cartheur/M68000-I-SBC/fabrication/production-draft/drill-report.txt

Drill report for 68000sbc.kicad_pcb
Created on 2026-10-28T14:22:47

Copper Layer Stackup:
    =============================================================
    L1 :  F.Cu                      front
    L2 :  B.Cu                      back

Drill file '68000sbc-PTH.drl' contains
    plated through holes:
    =============================================================
    T1  0.330mm  0.0130"  (269 holes))
    T2  0.700mm  0.0276"  (14 holes))
    T3  0.800mm  0.0315"  (341 holes))
    T4  0.900mm  0.0354"  (8 holes))
    T5  0.920mm  0.0362"  (4 holes))
    T6  1.000mm  0.0394"  (16 holes))
    T7  1.100mm  0.0433"  (8 holes))
    T8  2.330mm  0.0917"  (2 holes))
    T9  2.700mm  0.1063"  (4 holes))

    Total plated holes count 666

Drill file '68000sbc-NPTH.drl' contains
    unplated through holes:
    =============================================================

    Total unplated holes count 0
