cartheur/M68000-I-SBC/UPSTREAM.md

# Upstream provenance

This directory is an unmodified working-tree snapshot of
[74hc595/68k-nano](https://github.com/74hc595/68k-nano), imported from the
local clone on 2026-10-28.

- Upstream commit: `87066cffcea6371b3f1ad3f8cebd56c3ffa23dfe`
- Upstream commit date: 2020-07-11
- Upstream subject: `rom 0009910`
- License: BSD-3-Clause; see [LICENSE](LICENSE).

The upstream Git metadata was intentionally omitted so this repository does
not contain a nested Git worktree.  Keep local derivative work outside this
directory or document any intentional modifications here.

Included assets:

- `68000sbc.sch`, `68000sbc.kicad_pcb`, and `PadRows.pretty/`: hardware source
- `bom.txt`: original procurement list
- `code/`: monitor ROM, example programs, and build/upload utilities
- `README.md` and `API.md`: original technical documentation
- `images/board.jpg`: original board reference photo
