cartheur/M68000-I-SBC/SDIP-64/images/runs.jpg

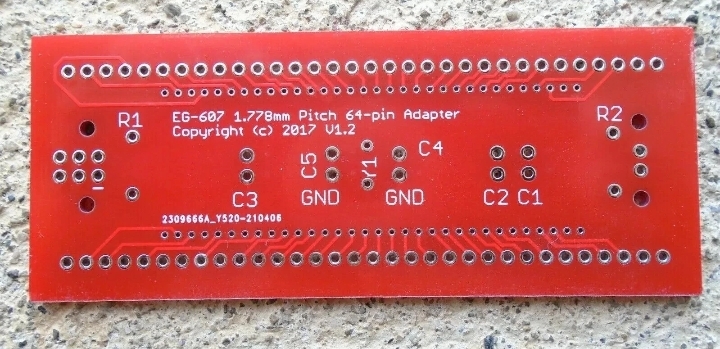
SDIP-64/images/runs.jpg
