cartheur/M68000-I-SBC/SDIP-64/images/sample.jpg

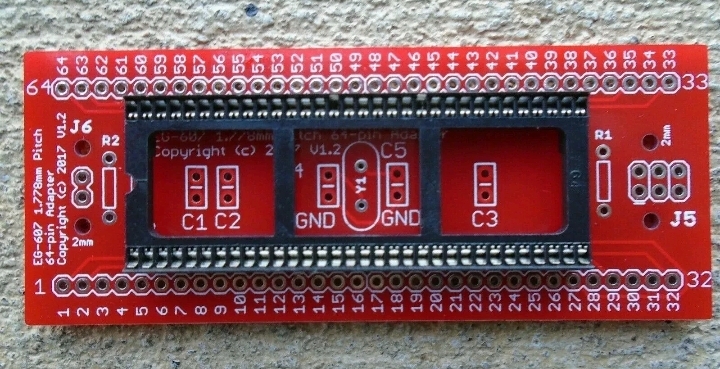
SDIP-64/images/sample.jpg
