cartheur/M68000-I-SBC/fabrication/production-draft/kicad-bom.csv

References | Value | Footprint | Quantity | DNP
C1-C10 | 0.1uF | Capacitor_THT:C_Rect_L7.0mm_W2.0mm_P5.00mm | 10
D1,D2 | 1N5817 | Diode_THT:D_DO-35_SOD27_P7.62mm_Horizontal | 2
D3 | POWER | LED_THT:LED_D5.0mm | 1
D4 | LED | LED_THT:LED_D5.0mm | 1
D5 | CARD | LED_THT:LED_D5.0mm | 1
D6 | HALT | LED_THT:LED_D5.0mm | 1
J1 | USB_B | Connector_USB:USB_B_OST_USB-B1HSxx_Horizontal | 1
J2 | 5V FTDI SERIAL | Connector_PinHeader_2.54mm:PinHeader_1x06_P2.54mm_Horizontal | 1
J3 | RTC (SparkFun BOB-10160) | Connector_PinHeader_2.54mm:PinHeader_1x07_P2.54mm_Vertical | 1
J4 | CFCARD/IDE | Connector_PinHeader_2.00mm:PinHeader_2x22_P2.00mm_Vertical | 1
J5 | EXPANSION (F.Cu) | PadRows:PadRow_1x25_P2.54mm | 1
J6 | EXPANSION (B.Cu) | PadRows:PadRow_1x25_P2.54mm | 1
JP1 | POWER SELECT | Connector_PinHeader_2.54mm:PinHeader_1x03_P2.54mm_Vertical | 1
R1,R2 | 10k | Resistor_THT:R_Axial_DIN0204_L3.6mm_D1.6mm_P7.62mm_Horizontal | 2
R3 | 1k | Resistor_THT:R_Axial_DIN0204_L3.6mm_D1.6mm_P7.62mm_Horizontal | 1
R4-R7 | 1k* | Resistor_THT:R_Axial_DIN0204_L3.6mm_D1.6mm_P7.62mm_Horizontal | 4
RN1 | 10k | Resistor_THT:R_Array_SIP7 | 1
SW1 | RESET | Button_Switch_THT:SW_PUSH_6mm | 1
SW2 | BTN1 | Button_Switch_THT:SW_PUSH_6mm | 1
U1 | 74HC139 | Package_DIP:DIP-16_W7.62mm_Socket | 1
U2 | 74HC14 | Package_DIP:DIP-14_W7.62mm_Socket | 1
U4,U6 | AS6C4008-55PCN | Package_DIP:DIP-32_W15.24mm_Socket | 2
U5,U7 | 28C256 | Package_DIP:DIP-28_W15.24mm_Socket | 2
U8 | TL16C550 | Package_DIP:DIP-40_W15.24mm_Socket | 1
X1 | 12MHz | Oscillator:Oscillator_DIP-14 | 1
X2 | 12MHz | Oscillator:Oscillator_DIP-8 | 1
