cartheur/M68000-I-SBC/(commit log)

2026-10-28 Initial version
    [68000sbc.kicad_pcb, 68000sbc.sch]
2026-10-28 Add local build and fabrication draft workflow
    [68000sbc-B_Cu.gbl, 68000sbc-B_Mask.gbs, 68000sbc-B_Paste.gbp, 68000sbc-B_Silkscreen.gbo, 68000sbc-Edge_Cuts.gm1, 68000sbc-F_Cu.gtl, 68000sbc-F_Mask.gts, 68000sbc-F_Paste.gtp]
2026-10-28 Add manufacturing sourcing drafts
    [full-placement-board-origin.csv, full-placement.csv, kicad-bom.csv, mouser-socket-bom.csv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]
2026-10-28 Clean KiCad migration artifacts
    [68000sbc.kicad_pcb]
2026-10-28 Update KiCad project settings
2026-10-28 Refresh KiCad DRC report
2026-10-28 Add pure source
    [68000sbc.kicad_pcb, 68000sbc.sch]
2026-10-28 Gate SBC repair on KiCad source recovery
2026-10-28 Add project 10 recovery
    [68000sbc.kicad_pcb, 68000sbc.sch]
2026-10-28 Incorporate legacy
    [68000sbc.kicad_sch]
2026-10-28 Record native KiCad 5 validation baseline
2026-10-28 Amend fiver
    [68000sbc-B_Cu.gbr, 68000sbc-B_Mask.gbr, 68000sbc-B_SilkS.gbr, 68000sbc-Edge_Cuts.gbr, 68000sbc-F_Cu.gbr, 68000sbc-F_Mask.gbr, 68000sbc-F_SilkS.gbr, 68000sbc-NPTH.drl]
2026-10-29 Add manuf file
    [68000sbc-B_Cu.gbr, 68000sbc-B_Mask.gbr, 68000sbc-B_SilkS.gbr, 68000sbc-Edge_Cuts.gbr, 68000sbc-F_Cu.gbr, 68000sbc-F_Mask.gbr, 68000sbc-F_SilkS.gbr, 68000sbc-NPTH.drl]
2026-10-31 Add Kicad advice
2026-10-31 Add SDIP64 adapter design documentation
    [SDIP64-to-DIP64-adapter.kicad_pcb]
2026-10-31 Rename adapter directory to SDIP-64
    [SDIP64-to-DIP64-adapter.kicad_pcb]
2026-10-31 Document SDIP adapter socket interface
2026-11-02 Add sample
2026-11-02 Add reproducible two-layer SDIP adapter baseline
    [SDIP64-to-DIP64-two-layer.kicad_pcb]
2026-11-02 Update board
    [68000sbc.kicad_pcb]
2026-11-02 Centre two-layer adapter and label host pins
    [SDIP64-to-DIP64-two-layer.kicad_pcb]
2026-11-02 Expand two-layer adapter routing clearance
    [SDIP64-to-DIP64-two-layer.kicad_pcb]
2026-11-02 Add runs
    [SDIP64-to-DIP64-two-layer.kicad_pcb]
2026-11-02 Add two-layer routing attempt
    [SDIP64-to-DIP64-two-layer-routing-attempt.kicad_pcb, SDIP64-to-DIP64-two-layer.kicad_pcb]
2026-11-02 Compact two-layer adapter fanouts
    [SDIP64-to-DIP64-two-layer-routing-attempt.kicad_pcb]
2026-11-02 Route complete two-layer SDIP adapter
    [SDIP64-to-DIP64-two-layer-routing-attempt.kicad_pcb]
2026-11-02 Add final draft
    [SDIP64-to-DIP64-two-layer-routing-attempt.kicad_pcb]
2026-11-02 Final draft for production
    [SDIP64-to-DIP64-two-layer-routing-attempt.kicad_pcb, SDIP64-to-DIP64-two-layer.kicad_pcb]
2026-11-02 Release two-layer adapter fabrication package
    [SDIP64-to-DIP64-adapter.kicad_pcb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]
2026-11-02 Properly name
    [SDIP64-to-DIP64-two-layer-B_Cu.gbl, SDIP64-to-DIP64-two-layer-Edge_Cuts.gm1, SDIP64-to-DIP64-two-layer-F_Cu.gtl, SDIP64-to-DIP64-two-layer-b_Silkscreen.gbo, SDIP64-to-DIP64-two-layer-f_Silkscreen.gto, SDIP64-to-DIP64-two-layer-job.gbrjob, SDIP64-to-DIP64-two-layer.drl]
2026-11-02 Refresh two-layer fabrication outputs
    [SDIP64-to-DIP64-two-layer-B_Cu.gbl, SDIP64-to-DIP64-two-layer-Edge_Cuts.gm1, SDIP64-to-DIP64-two-layer-F_Cu.gtl, SDIP64-to-DIP64-two-layer-b_Silkscreen.gbo, SDIP64-to-DIP64-two-layer-b_soldermask.gbs, SDIP64-to-DIP64-two-layer-f_Silkscreen.gto, SDIP64-to-DIP64-two-layer-f_soldermask.gts, SDIP64-to-DIP64-two-layer-job.gbrjob]
2026-11-02 Update two-layer silkscreen fabrication files
    [SDIP64-to-DIP64-two-layer-B_Cu.gbl, SDIP64-to-DIP64-two-layer-Edge_Cuts.gm1, SDIP64-to-DIP64-two-layer-F_Cu.gtl, SDIP64-to-DIP64-two-layer-b_Silkscreen.gbo, SDIP64-to-DIP64-two-layer-b_soldermask.gbs, SDIP64-to-DIP64-two-layer-f_Silkscreen.gto, SDIP64-to-DIP64-two-layer-f_soldermask.gts, SDIP64-to-DIP64-two-layer-job.gbrjob]
